Mostafa-Samy-Mohammed/MCT411-HybridControlSystems-Project/report/hybrid_report_team16.pdf

# Final Project Report

# – Team 16 –

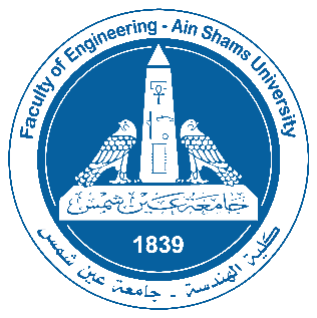
[picture p1: figure]

Name | ID
Amr Khaled Taha | 2101427
Mostafa Samy Mohammed | 2100349
Omar Mohsen Mohamed | 2100881
Youssef Ahmed Mahmoud El-Gharably | 2101548
Youssef Mostafa Kamel Mohamed | 2101019

Submitted to:
Dr. Mohamed Ibrahim Awad
Dr. Mohamed Hamdy
Eng. Hesham Salah
Eng. Mohab Ahmed

AIN SHAMS UNIVERSITY
FACULTY OF ENGINEERING

Hybrid Control Systems MCT411s Fall 2025 / Mechatronics Senior-2

2 | P a g e

## Table of Contents

3 | P a g e

## List of figures

Figure 1. Parameter estimation experiment [1] plot | 5
Figure 2. Parameter estimation experiment [2] plot | 6
Figure 3. Parameter estimation validation plot | 6
Figure 4. Simscape multibody block diagram of the system | 7
Figure 5. DC motor model | 8
Figure 6. The system model in mechanics explorer | 8
Figure 7. Linearization result state space model | 9
Figure 8. SIL [Software in the loop] | 11
Figure 9. Motor's angular velocity graph | 12
Figure 10. Motor's torque graph | 12
Figure 11. Manufactured rotary inverted pendulum | 13
Figure 12. Rotary inverted pendulum [Furuta pendulum] | 14
Figure 13. HIL block diagram | 15
Figure 14. Encoder's feedback | 16
Figure 15. Angle wrapping function block | 16
Figure 16. Linearity condition block diagram | 17
Figure 17. Linearity condition block | 17
Figure 18. Hardware interface and PWM generation | 18

## List of tables

Table 1. DC Motor parameters | 7
Table 2. Bill of materials [Electrical components] | 14

4 | P a g e

## Executive Summary

This report documents the design, modeling, and implementation of a Furuta Pendulum (Rotary Pendulum) control system. The primary objective is to stabilize the pendulum in the upright position (θ1 = 0) and reject external disturbances using a Linear Quadratic Regulator (LQR) combined with an energy-based Swing-Up controller.

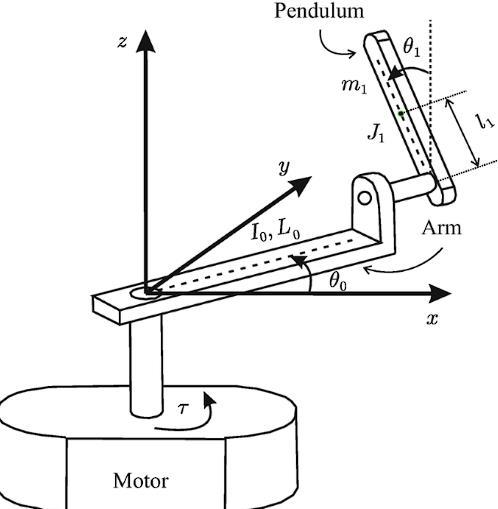
[picture p2: figure]

- Project Pipeline & Methodology: The project followed a structured pipeline architecture:

### 1. System Design: Selection of mechanical and electrical components including a

custom PCB shield for the ESP32 microcontroller and Cytron MDD3A driver.

### 2. Parameter Estimation: Identification of DC motor electrical and mechanical

parameters using a Transfer Function (TF) block diagram approach.

### 3. Advanced Modeling: Import of the Solidworks CAD model into MATLAB Simscape

Multibody. The plant model was linearized around the upright position (θ = 0) using the identified motor torque as the joint input.
Implementation: Hardware-in-the-Loop (HIL) deployment using the ESP32 platform.
Key Achievements:
- Successfully derived a linearized state-space model from Simscape Multibody.
- Designed and tuned an LQR controller for stabilization and an energy-pumping controller for swing-up.
- Validated performance via HIL simulation showing stable regulation within required settling times.
- Demonstrated robustness against manual disturbances as per project requirements.

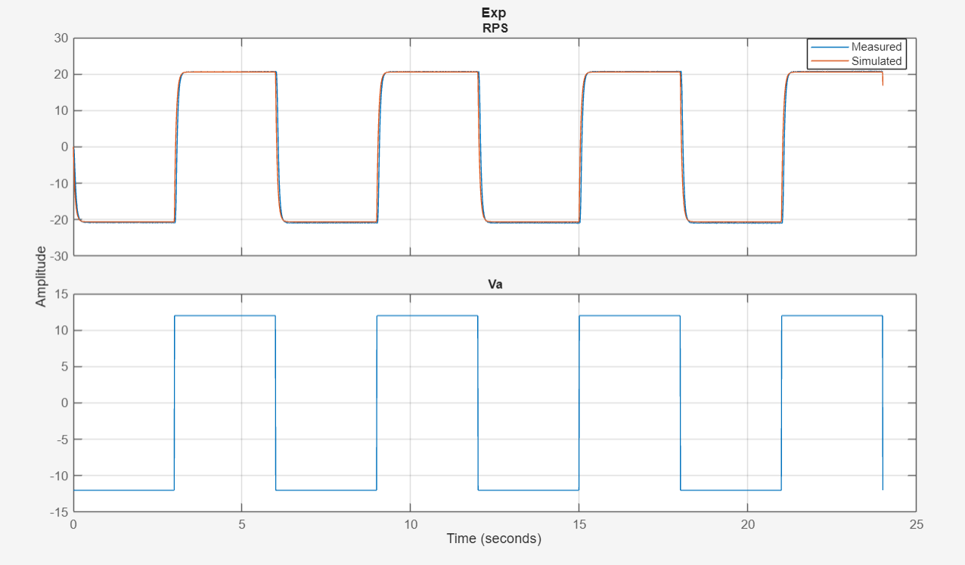
[picture p3: figure]

5 | P a g e

## Objectives

1- Use pole placement / LQR techniques to control the pendulum.
2- Control the angle θ1 to be zero. So, the pendulum stands in the upright position. 3- Overcome any disturbances that may affect the pendulum. So, the pendulum should maintain its upright position and not fall.

## System Modeling

System Description
The Furuta Pendulum consists of a horizontal rotating arm (actuated by a DC motor) and a non-actuated vertical pendulum. The system is underactuated, having two degrees of freedom but only one control input (motor torque τ).
Parameter estimation
To ensure high-fidelity simulation, the DC motor parameters were estimated rather than relying solely on datasheet values by collecting data from the motor’s encoder at different voltages with square signal generator. For validation we have also operated the motor with staircase signal voltage.

Analysis

Figure 1. Parameter estimation experiment [1] plot

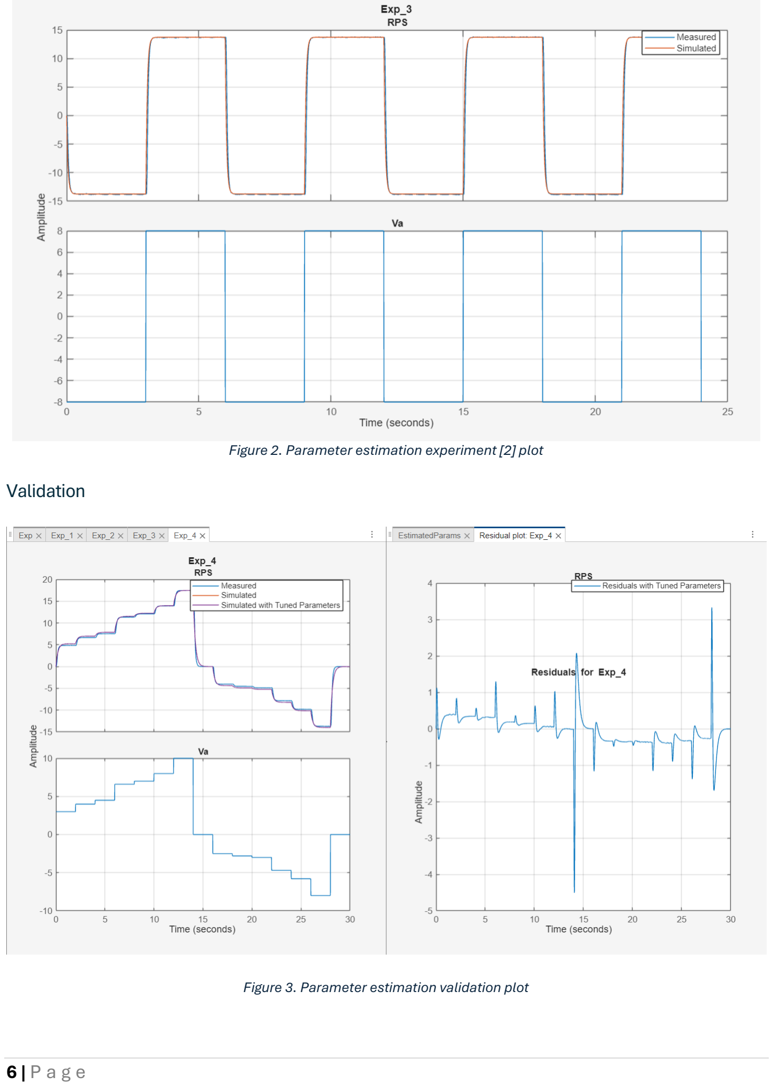
[picture p4: page 6]

6 | P a g e

Figure 2. Parameter estimation experiment [2] plot
Validation

Figure 3. Parameter estimation validation plot

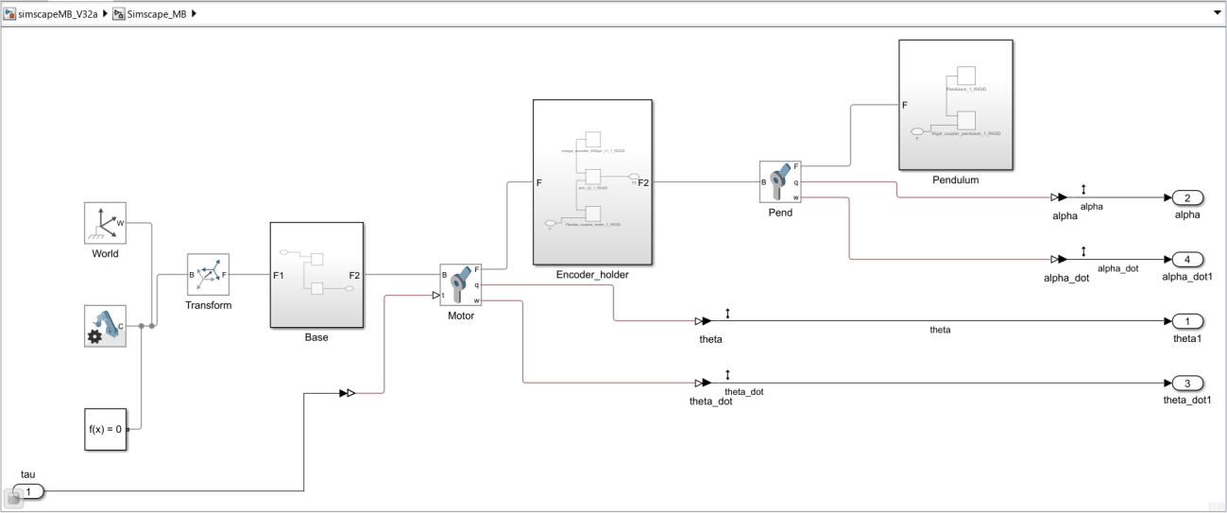
[picture p5: figure]

7 | P a g e

Results
Using a Transfer Function block diagram approach, we identified the following parameters for the motor equivalent circuit and mechanical dynamics:

Table 1. DC Motor parameters

Parameter | Symbol | Estimated Value
Armature Resistance | Ra | 9.86 Ω
Inductance | La | 0.00045 H = 0.45 mH
Back-EMF Constant | Kb | 0.5686 V/(rad/s)
Torque Constant | Kt | 1.2739 N ∙ m/A
Rotor Inertia | Jm | 0.0068 kg ∙ m²
Viscous Friction | bm | 0.0018 N ∙ m ∙ s
Simscape Multibody Model
Instead of manual Euler-Lagrange derivation alone, the system dynamics were modeled by importing the Solidworks CAD assembly into MATLAB Simscape Multibody.
1. CAD Import: The Solidworks model was exported to an XML definition and imported into Simulink.

Figure 4. Simscape multibody block diagram of the system
2. Actuation: The identified DC motor model (from Section 1.2) was coupled to the arm joint, providing torque τ based on voltage input V.

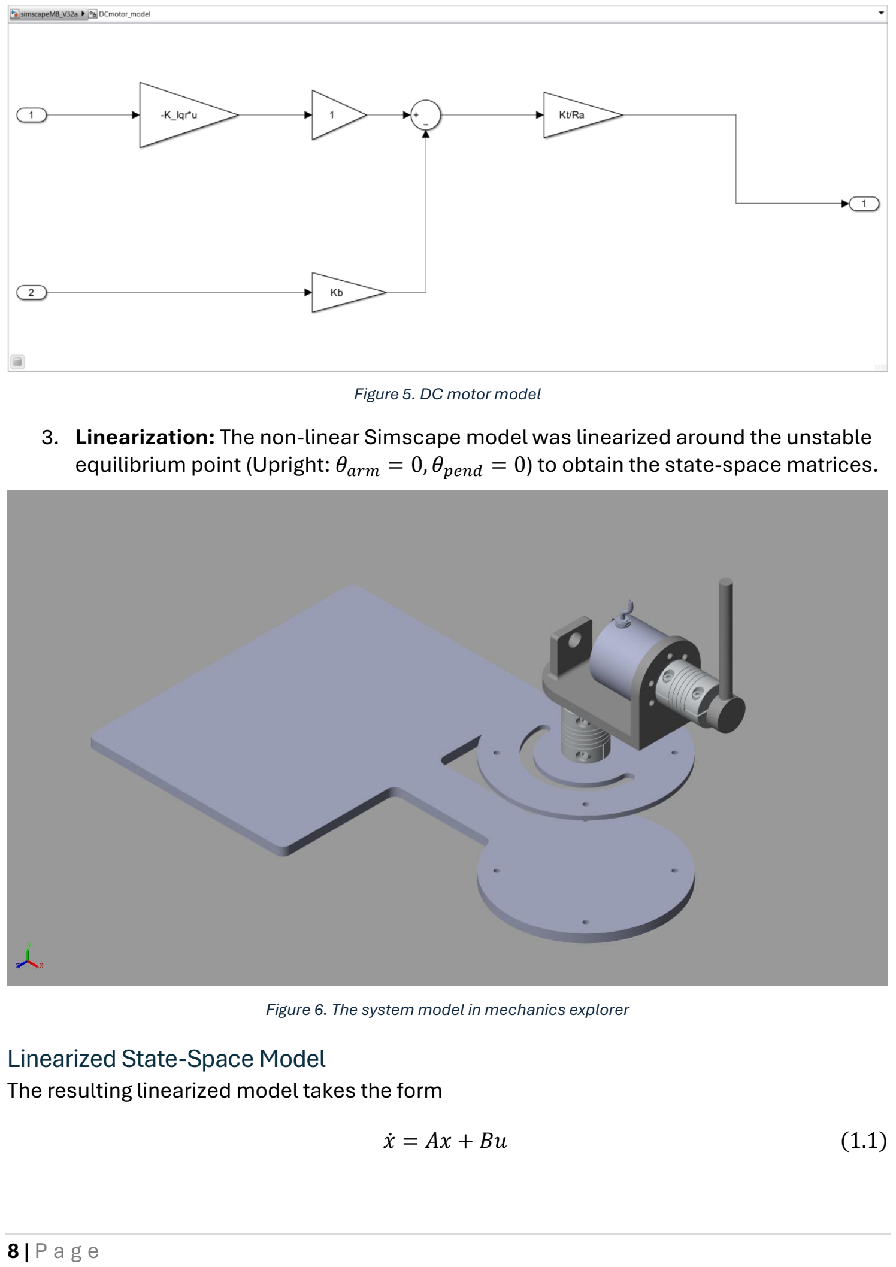
[picture p6: page 8]

8 | P a g e

Figure 5. DC motor model
3. Linearization: The non-linear Simscape model was linearized around the unstable equilibrium point (Upright: θarm = 0, θpend = 0) to obtain the state-space matrices.

Figure 6. The system model in mechanics explorer
Linearized State-Space Model
The resulting linearized model takes the form
ẋ = Ax + Bu | (1.1)

9 | P a g e
y = Cx + Du | (1.2)
, where:
- State vector
x = [θ0, α1, θ̇
0, α̇1]

T
(1.3)
- Output vector
u = [θ0, α1
] | (1.4)
- System parameters matrix
A = [
0 | 1 | 0 | 0
0 | 0 | 0 | 1
~0 a32 | a33 | ~0
~0 a42 | a43 | a44
] | (1.5)

B = [

0
b2
0
b4
] | (1.6)

C = [

1 0 0 0
0 1 0 0
] | (1.7)
D = 0 | (1.8)
Results
After linearization of the system at θ = 180∘

, the result state space model is given below:

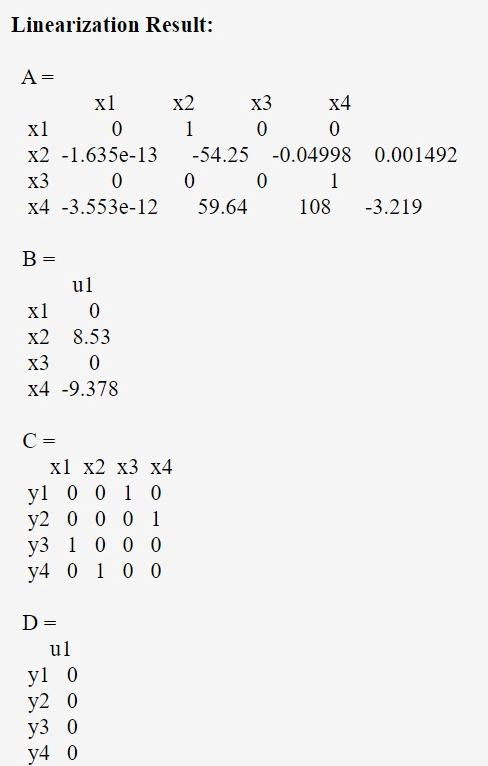
[picture p7: figure]

Figure 7. Linearization result state space model

10 | P a g e

## Controller Design

Control Strategy
The control architecture consists of two distinct controllers switched based on the pendulum’s state:
1. Swing-Up Controller: Brings the pendulum from the downward (stable) position to the upright region [−

π
8

∶

π
8

].
2. Stabilization Controller (LQR): Balances the pendulum once it is within a small angular threshold of the upright position [−

π
8

∶

π
8

].
Stabilization: LQR Design
We utilized the Linear Quadratic Regulator (LQR) method to calculate the optimal gain matrix K that minimizes the cost function:

J = ∫ (x
TQx + u

TRu)

∞

0

dt | (2)

Weight Selection
The weighting matrices were tuned to prioritize pendulum angle error (θ1) minimization while respecting motor voltage limits.

Q = [

Qθ | 0 | 0 | 0
0 | Qα | 0 | 0
0 | 0 | Qθ̇ | 0
0 | 0 | 0 | Qα̇

] = [

10 | 0 | 0 | 0
0 | 250 | 0 | 0
0 | 0 | 1.5 | 0
0 | 0 | 0 | 80] | (3)
R = Ru = 3 | (4)
Resulting Gain
The calculated state-feedback gain K:
K = [k1 k2 k3 k4
] = [ − 2.2361 219.4128 − 2.0954 14.9704] | (5)
Swing-Up Controller

The fundamental idea is based on the Total Mechanical Energy ($E$) of the system. The controller treats the pendulum as an energy management problem rather than a trajectory tracking problem.

1. Target Energy [Eref]: You calculate the potential energy the pendulum possesses when it is perfectly upright and stationary. This is your reference energy.
2. Current Energy [E]: At every time step, the system calculates the pendulum's current kinetic and potential energy.
3. Energy Error: The difference between the two (E − Eref) dictates the control action.

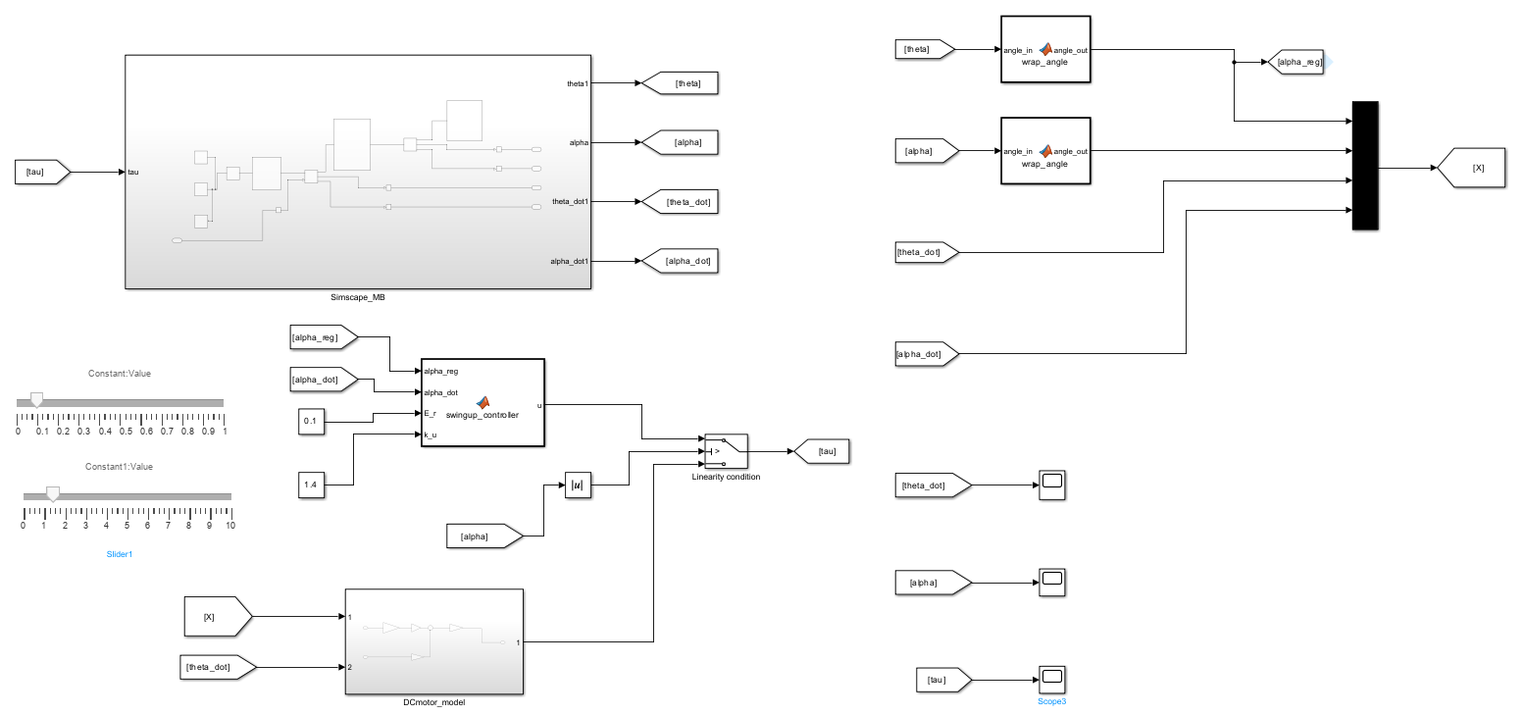
[picture p8: figure]

11 | P a g e

Mathematically, the control law u (torque applied to the rotary base) often looks like this:

u = k ⋅ (E − Eref) ⋅ α̇ ⋅ cos α | (6)
, where:
- k is a tunable gain.
- E is the current total energy.
- α̇ is the pendulum angular velocity.
- cos α ensures the force is applied effectively relative to the arm's rotation (geometric coupling).

## Software-in-the-loop (SIL)

To ensure the reliability and safety of the control algorithms prior to physical deployment, a high-fidelity Software-in-the-Loop (SIL) simulation environment was developed. This architecture decouples the control logic from the physical hardware, allowing the exact control code to be tested against a virtual "digital twin" of the rotary inverted pendulum.

Figure 8. SIL [Software in the loop]

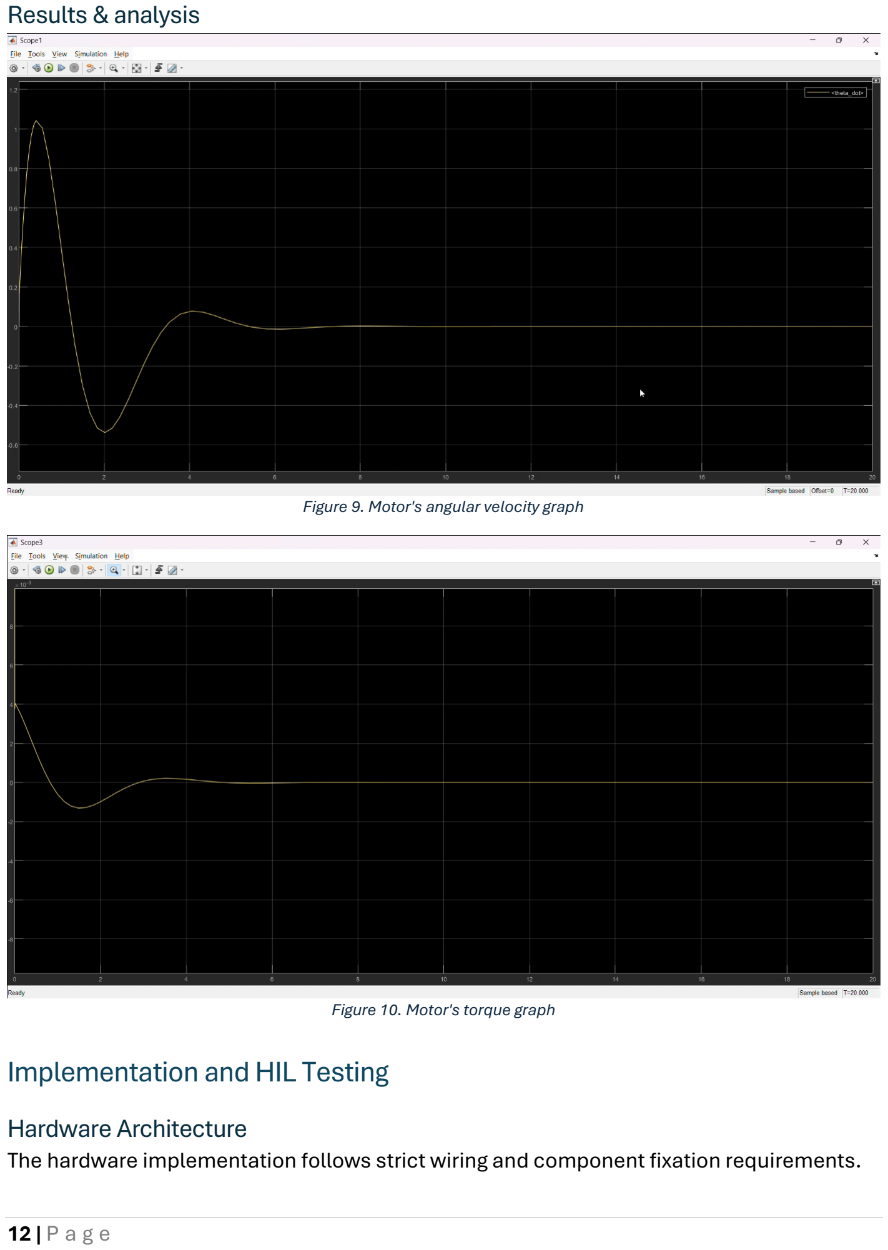
[picture p9: page 12]

12 | P a g e

Results & analysis

Figure 9. Motor's angular velocity graph

Figure 10. Motor's torque graph

## Implementation and HIL Testing

Hardware Architecture
The hardware implementation follows strict wiring and component fixation requirements.

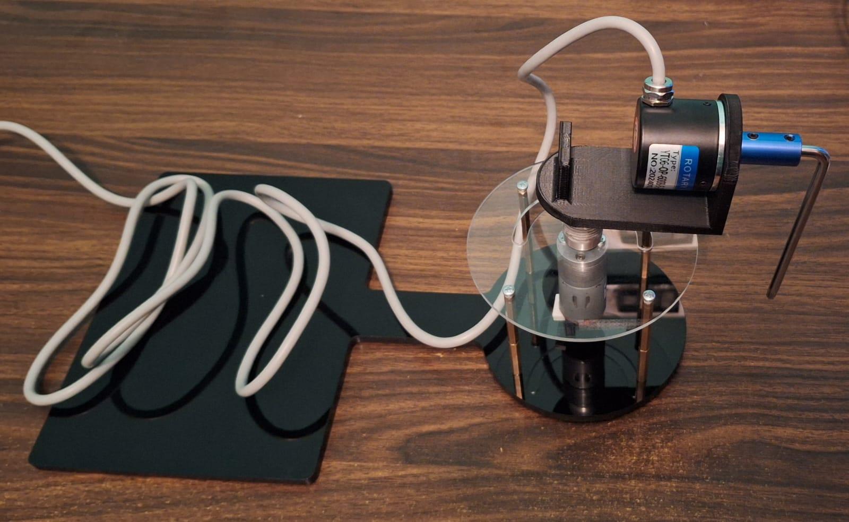
[picture p10: figure]

13 | P a g e

Figure 11. Manufactured rotary inverted pendulum

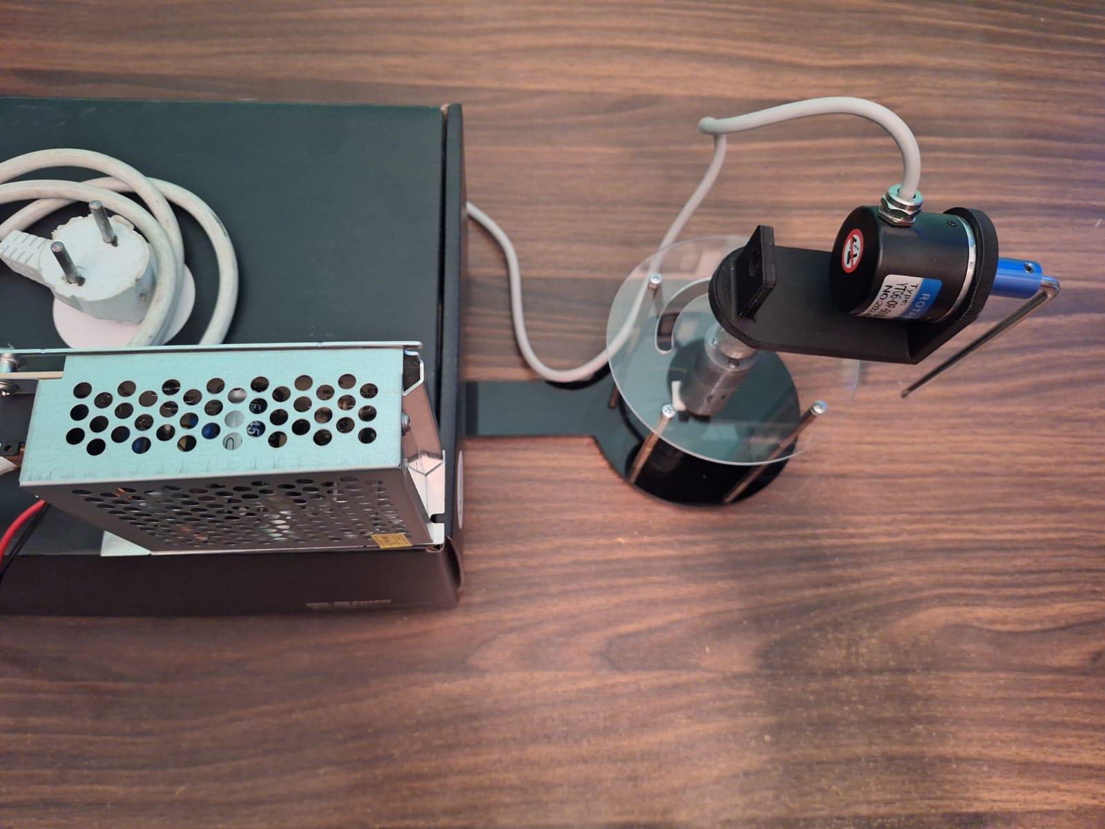
[picture p11: figure]

14 | P a g e

Figure 12. Rotary inverted pendulum [Furuta pendulum]
Electronics and PCB
To ensure reliability and reduce wiring clutter, a custom PCB shield was designed for the microcontroller.

Table 2. Bill of materials [Electrical components]
Component | Model/Specs | Role
Microcontroller | ESP32-DevkitC-38pin | Main controller (HIL Interface)
Motor driver | Cytron MDD3A | High-current DC motor drive
Power supply | 12V DC – 5A Supply | System power supply
Rotary incremental encoder | 11 PPR [2090 PPR after gearbox in MATLAB Simulink]
Optical rotary incremental encoder | 600 PPR [2400 PPR in MATLAB Simulink] | State feedback (θ0, θ1)
Shield | Custom PCB | Interconnects ESP32, Driver, and Encoders

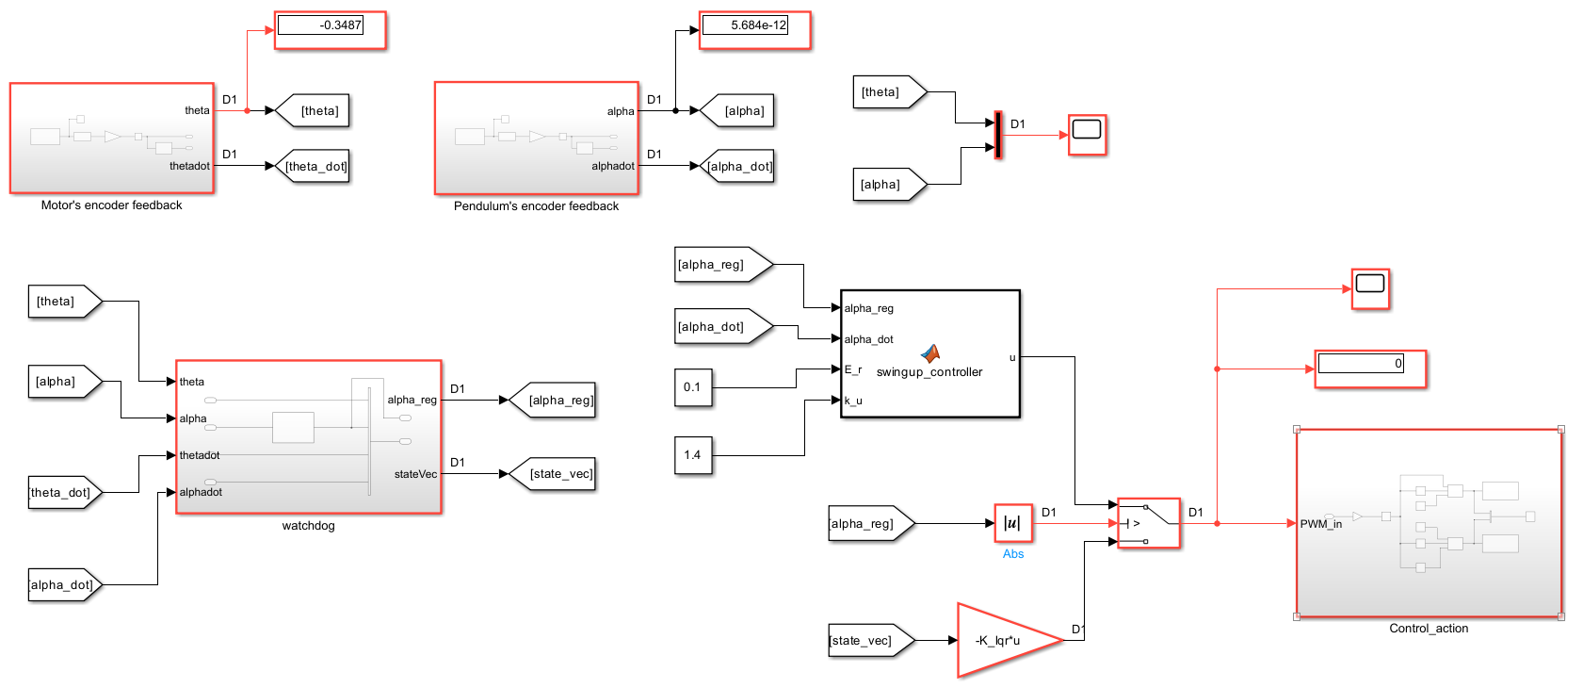
[picture p12: figure]

15 | P a g e

Hardware-in-the-Loop (HIL)
Hardware-in-the-Loop (HIL) implementation for the autonomous Furuta inverted pendulum project. The system is designed to interface an ESP32 microcontroller with MATLAB/Simulink to achieve real-time balancing control using an LQR (Linear Quadratic Regulator) strategy.

Figure 13. HIL block diagram

### 1. Encoder Feedback and State Estimation

The first stage of the HIL system focuses on acquiring the physical states of the pendulum. The system utilizes two distinct encoder inputs: one for the DC motor (arm position) and one for the rotary encoder (pendulum angle). Within the Simulink environment, raw encoder counts are received via hardware interruptions and converted into a double precision format. These counts are then scaled by a gain block (deg) and converted to radians (D2R) to represent the angular position, theta.
To derive the angular velocity, theta_dot, the signal is passed through a Filtered Derivative block. This block implements a first-order lead-lag transfer function, s/(0.03s+1), which calculates the derivative while simultaneously applying a low-pass filter with a 0.03s time constant. This filtering is critical to mitigate the high-frequency quantization noise inherent in digital encoder signals, ensuring a smooth velocity estimate for the LQR controller.

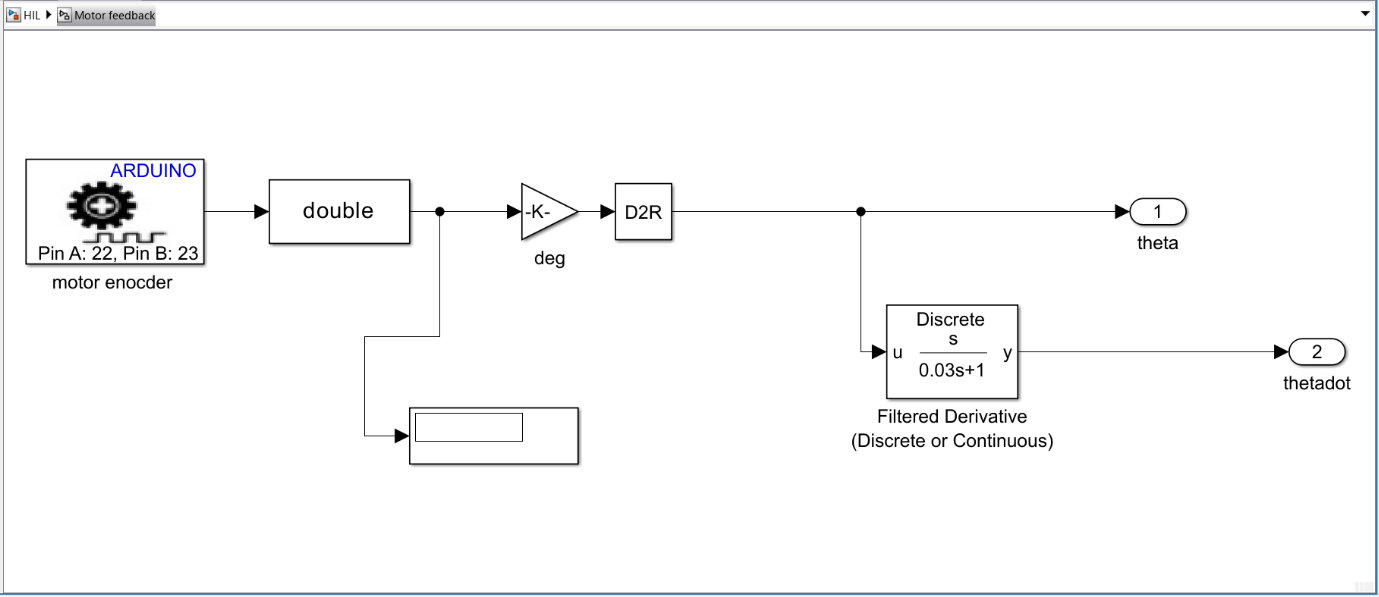
[picture p13: figure]

16 | P a g e

Figure 14. Encoder's feedback

### 2. Angle Wrapping Logic

To ensure the controller operates within a consistent coordinate system, the angular data is processed through an Angle Wrapper section. This is implemented via a MATLAB Function block that constrains the input angle (in radians) to the range [-pi, pi]. The wrapping is achieved using the trigonometric identity atan2(sin(angle_in), cos(angle_in)). This operation prevents the controller from attempting to "unwind" the pendulum if it completes multiple full rotations, maintaining a continuous and bounded state representation for both the arm and the pendulum angles.

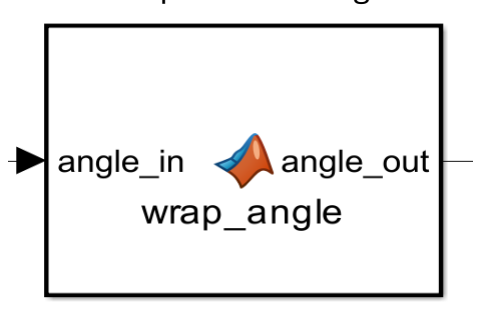
[picture p14: figure]

Figure 15. Angle wrapping function block

### 3. Linearity Condition and LQR Control Switching

The control logic employs a Linearity Condition to manage the transition between the inactive state and active balancing. The system monitors the absolute value of the wrapped pendulum angle (|u|). A switch block, labeled "linearity condition," remains at a default output of 0 until the pendulum is manually swung into the upright vertical position.

17 | P a g e

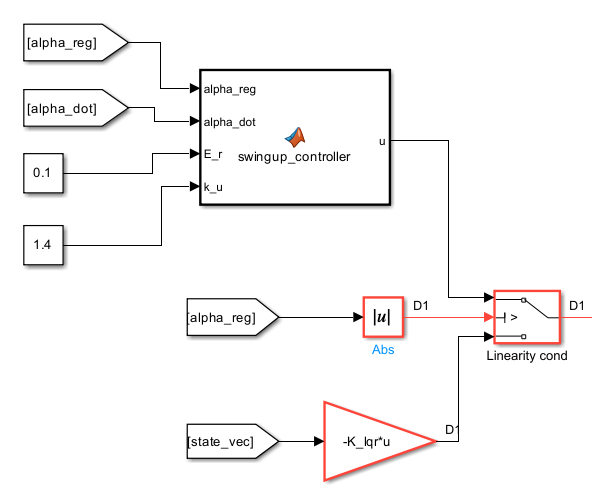
[picture p15: figure]

Figure 16. Linearity condition block diagram
When the pendulum angle (alpha) falls within the linear region—defined as being less than pi/8 radians from the vertical—the system switches to the active control state. In this mode, the full state vector of the inverted pendulum is multiplied by the pre-calculated LQR Gains (K). This LQR strategy minimizes a cost function to provide the optimal torque required to stabilize the pendulum in the upright position.

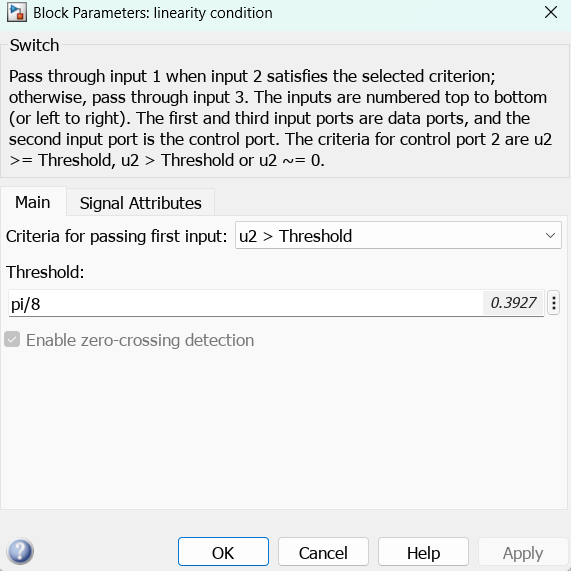
[picture p16: figure]

Figure 17. Linearity condition block

### 4. Motor Hardware Interface and PWM Generation

The final section translates the calculated control action into physical movement via the motor driver. The control signal is first processed through a gain and a saturation block to

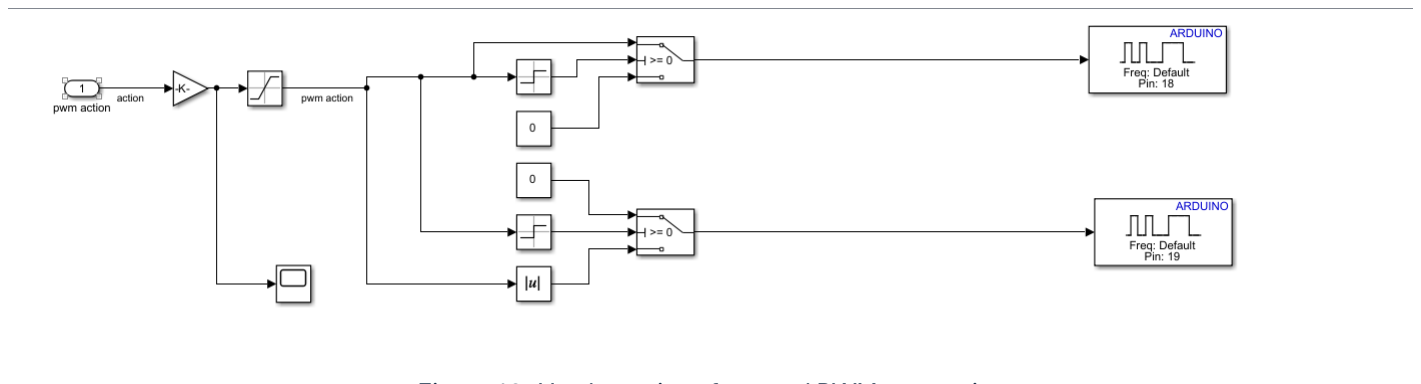
[picture p17: figure]
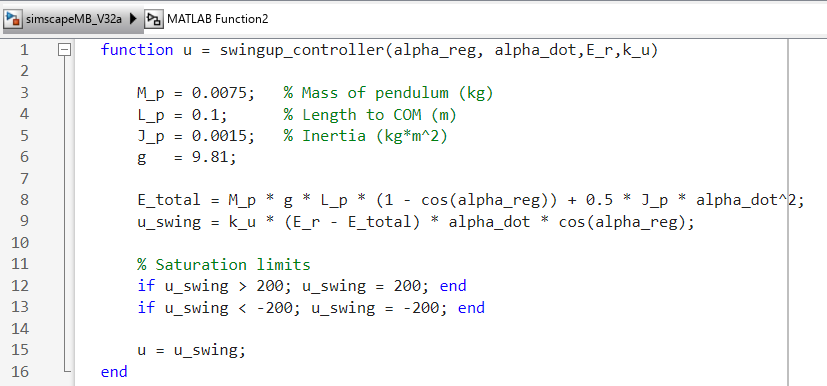
[picture p18: figure]

18 | P a g e

ensure the PWM action remains within the hardware limits of the Cytron motor driver. This saturated signal is then split into two paths to control the motor direction and speed.

Using logic gates and switch blocks, the system determines the sign of the control action. If the action is positive, a PWM signal proportional to the absolute value (|u|) is sent to Pin 18, while Pin 19 is held at 0. Conversely, if the action is negative, the PWM signal is routed to Pin 19 while Pin 18 is grounded. These digital outputs are sent directly to the ESP32 pins to drive the motor, completing the real-time HIL control loop.

Figure 18. Hardware interface and PWM generation

## Appendix

Swing-up controller function

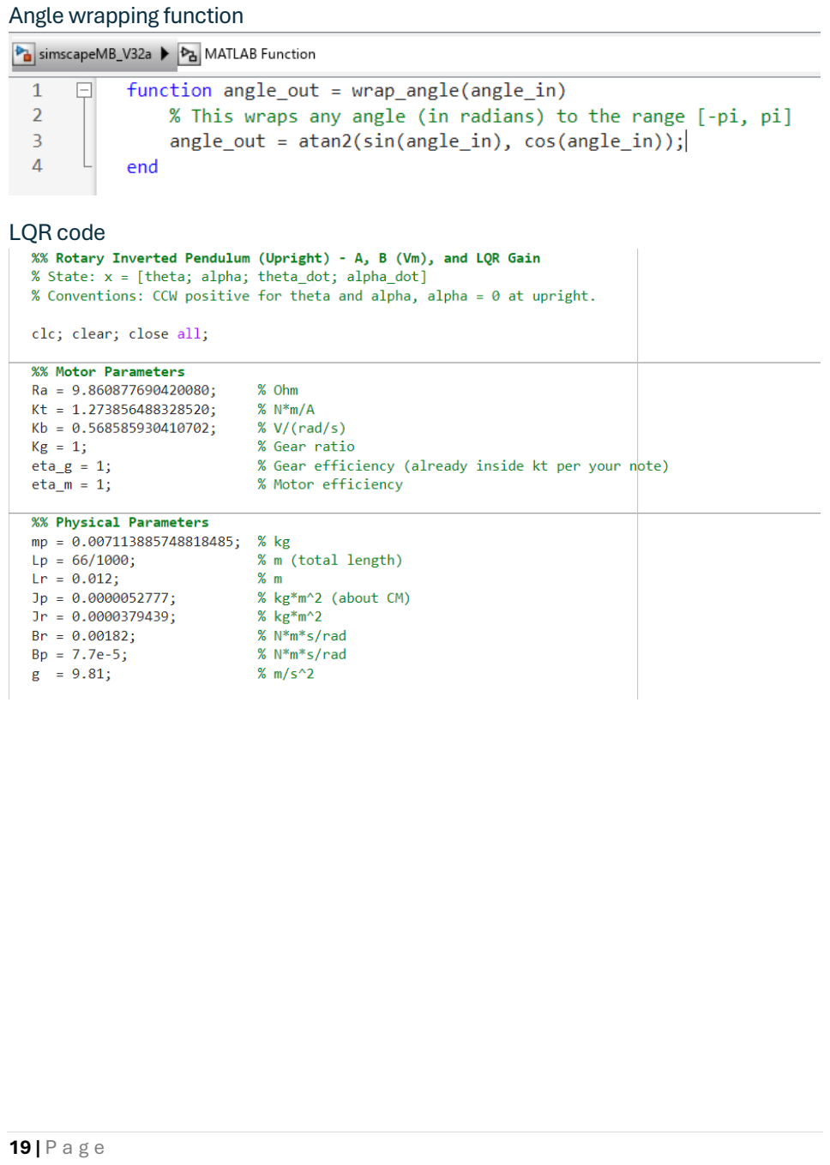
[picture p19: page 19]

19 | P a g e

Angle wrapping function

LQR code

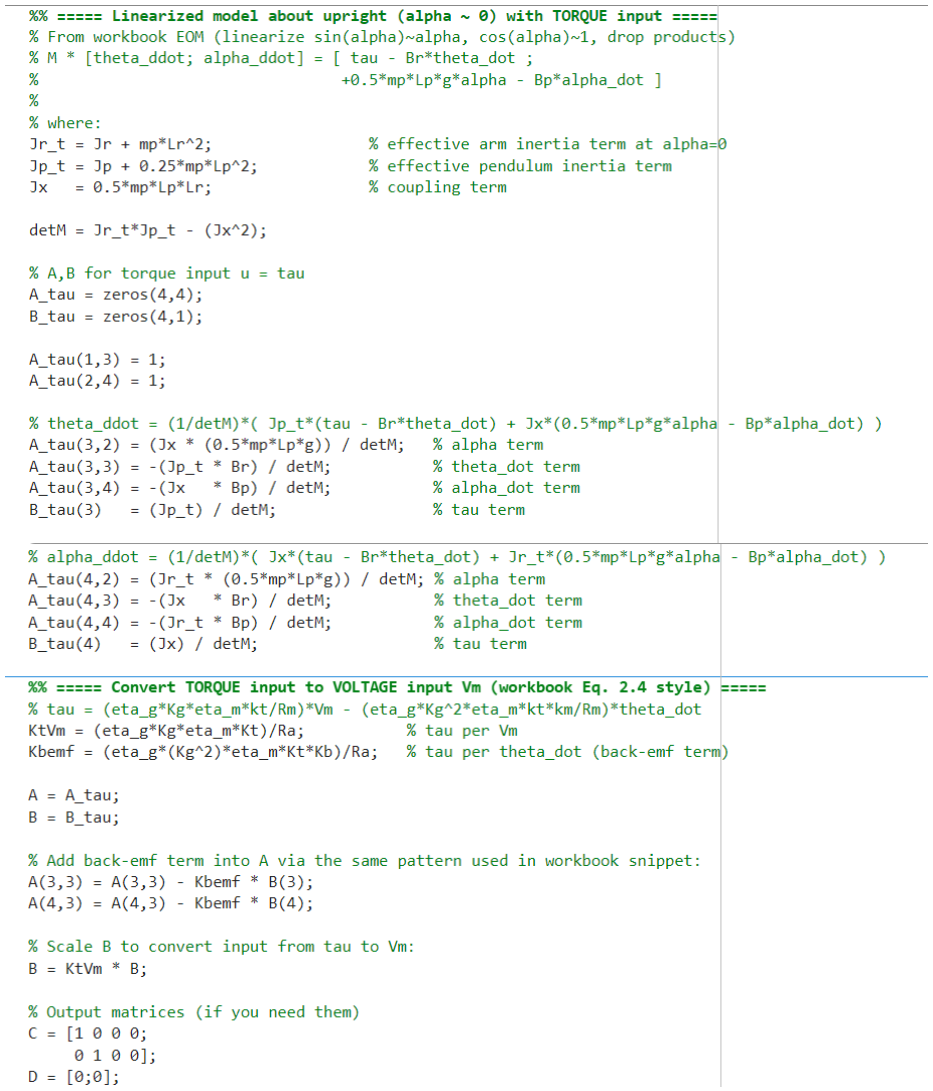
[picture p20: figure]

20 | P a g e

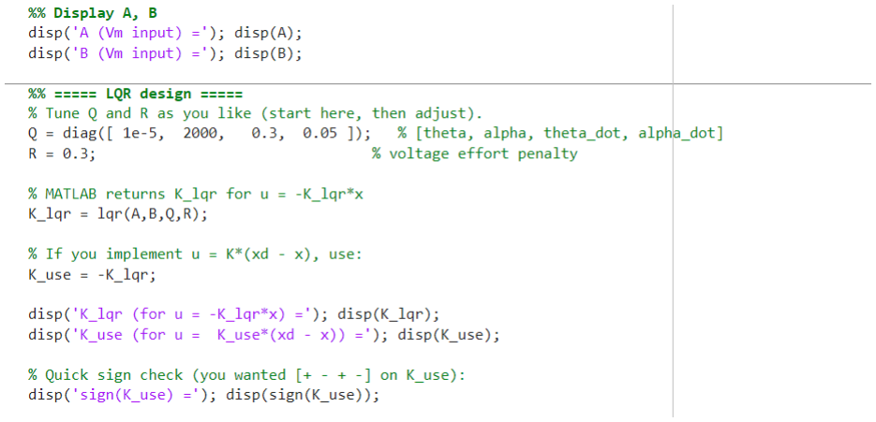
[picture p21: figure]

21 | P a g e
