Mostafa-Samy-Mohammed/MCT411-HybridControlSystems-Project/CAD/Assem1.SLDASM

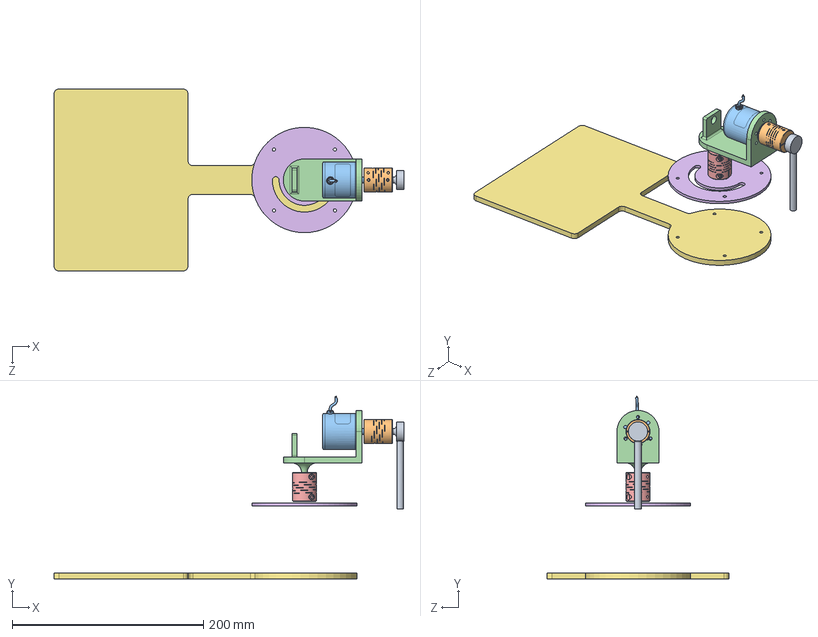
[picture p22: CAD file, 2025-12-24]
CAD/Assem1.SLDASM
365.6 x 190.7 x 190.0 mm
base_plate
dcMotor_plate
Flexible_coupler_motor
arm_v2
orange_encoder_600ppr v1
Rigid_coupler_pendulum
Pendulum
