Mostafa-Samy-Mohammed/MCT411-HybridControlSystems-Project/CAD/Flexi_spojka_D25 L30.SLDPRT

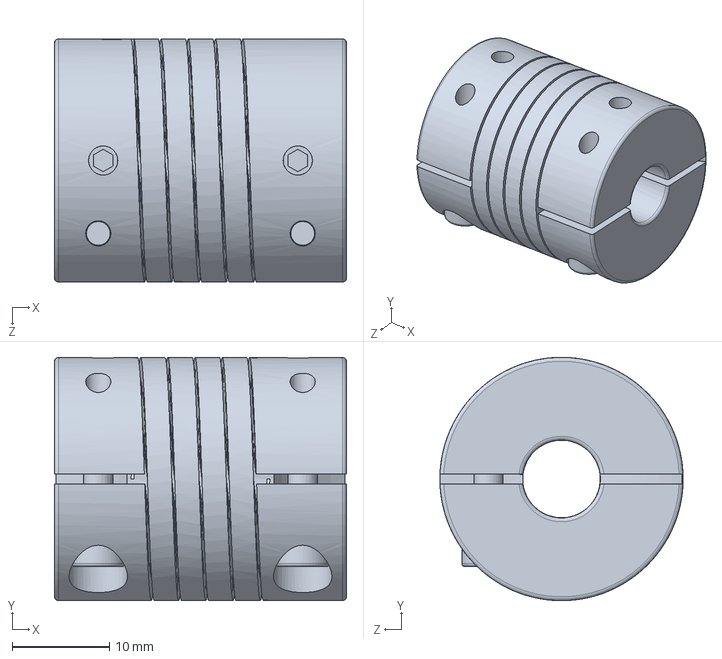
[picture p23: CAD file, 2025-12-24]
CAD/Flexi_spojka_D25 L30.SLDPRT
30.0 x 25.0 x 25.0 mm
