Mostafa-Samy-Mohammed/MCT411-HybridControlSystems-Project/CAD/Simscape-Multibody/dcMotor_plate_Default_sldprt.STEP

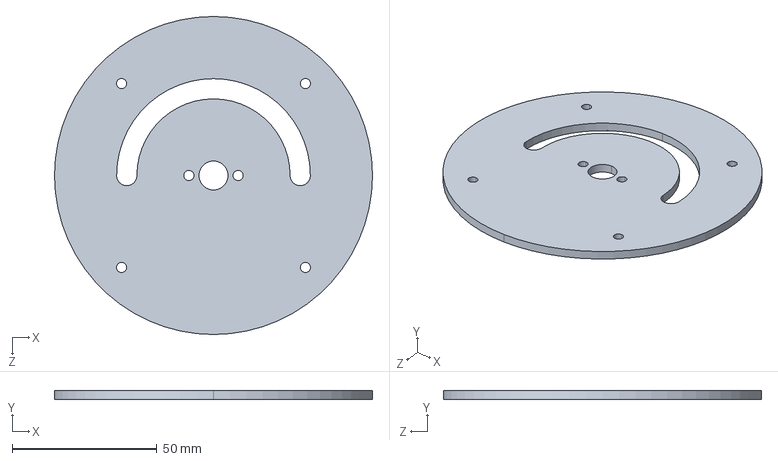
[picture p24: CAD file, 2025-12-24]
CAD/Simscape-Multibody/dcMotor_plate_Default_sldprt.STEP
110.0 x 3.00 x 110.0 mm
