Mostafa-Samy-Mohammed/MCT411-HybridControlSystems-Project/CAD/Simscape-Multibody/arm_v2_Default_sldprt.STEP

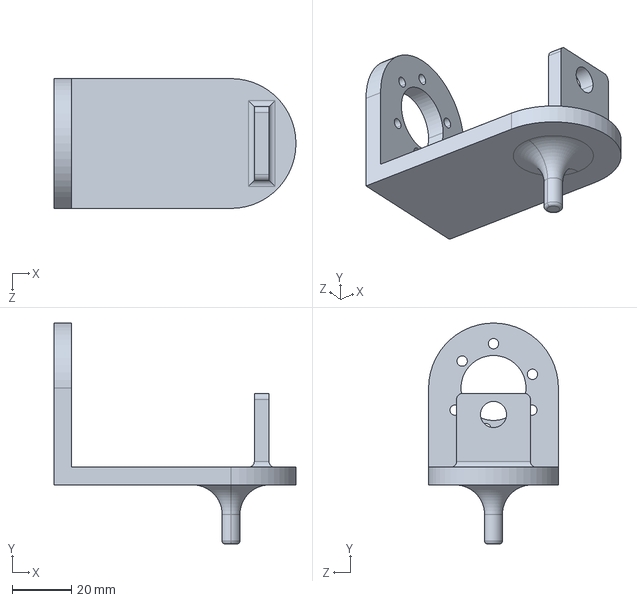
[picture p25: CAD file, 2025-12-24]
CAD/Simscape-Multibody/arm_v2_Default_sldprt.STEP
82.0 x 74.8 x 44.0 mm
