Mostafa-Samy-Mohammed/MCT411-HybridControlSystems-Project/CAD/orange_encoder_600ppr v1.SLDPRT

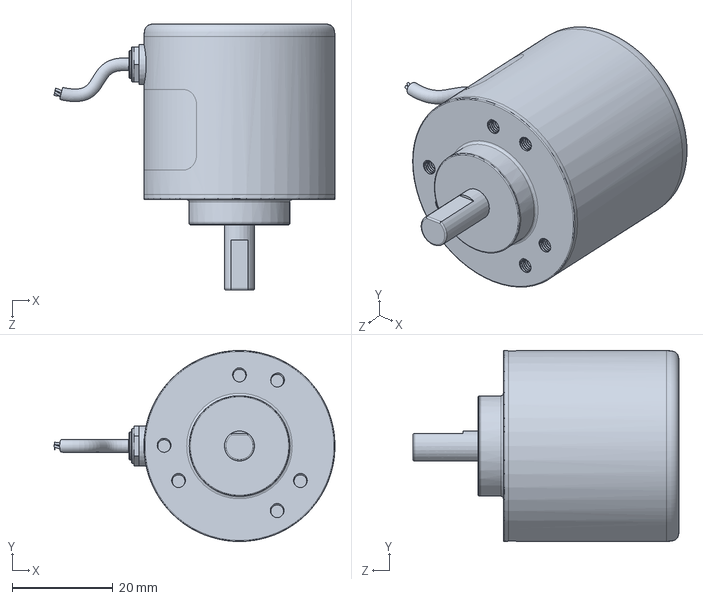
[picture p26: CAD file, 2025-12-24]
CAD/orange_encoder_600ppr v1.SLDPRT
55.9 x 38.0 x 53.0 mm
