Mostafa-Samy-Mohammed/MCT411-HybridControlSystems-Project/CAD/Simscape-Multibody/base_plate_Default_sldprt.STEP

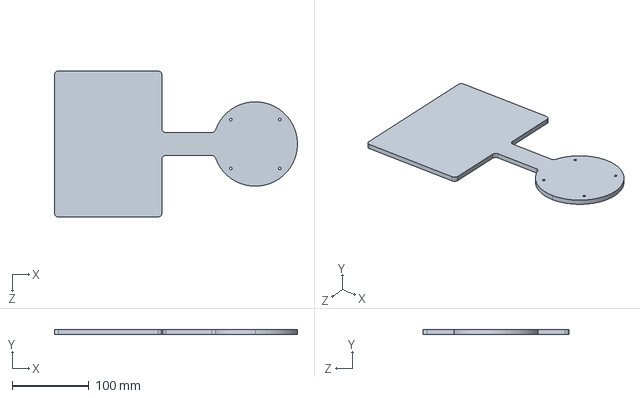
[picture p27: CAD file, 2025-12-24]
CAD/Simscape-Multibody/base_plate_Default_sldprt.STEP
316.6 x 6.00 x 190.0 mm
