Mostafa-Samy-Mohammed/MCT411-HybridControlSystems-Project/CAD/Simscape-Multibody/Rigid_coupler_pendulum_Default_sldprt.STEP

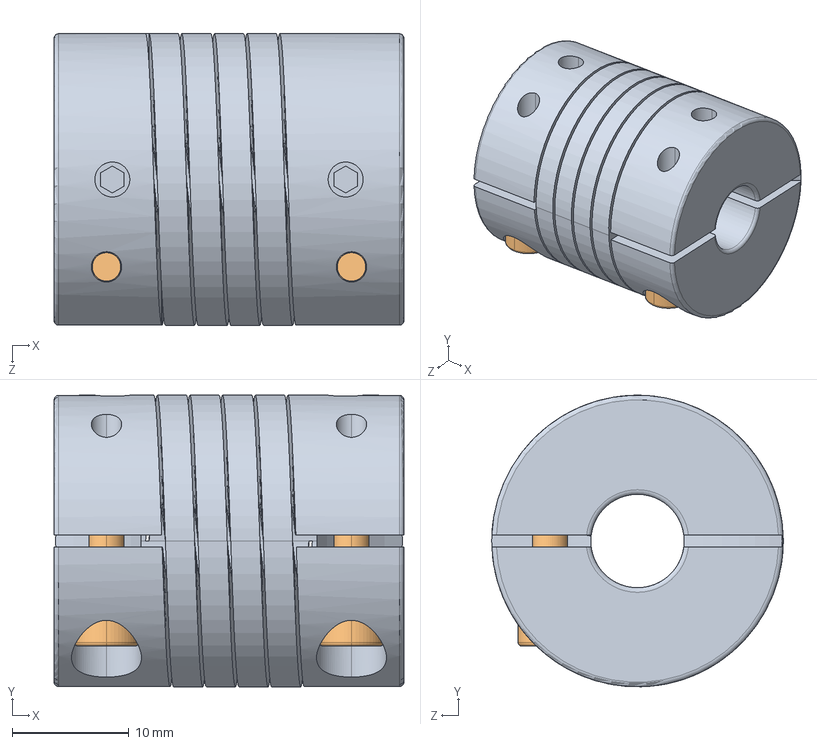
[picture p28: CAD file, 2025-12-24]
CAD/Simscape-Multibody/Rigid_coupler_pendulum_Default_sldprt.STEP
30.0 x 25.0 x 25.0 mm
