Mostafa-Samy-Mohammed/MCT411-HybridControlSystems-Project/CAD/Simscape-Multibody/Pendulum_Default_sldprt.STEP

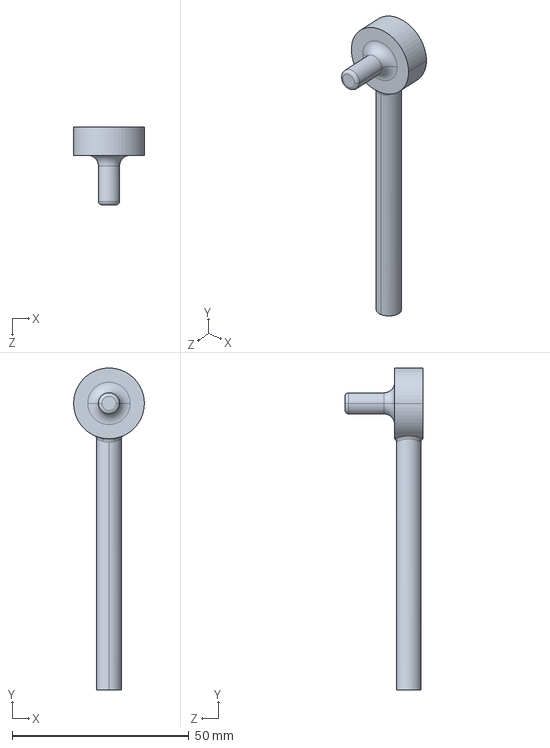
[picture p29: CAD file, 2025-12-24]
CAD/Simscape-Multibody/Pendulum_Default_sldprt.STEP
20.0 x 91.0 x 22.0 mm
