Mostafa-Samy-Mohammed/MCT411-HybridControlSystems-Project/(list of files, cad)

Other CAD files:
CAD/Rigid_coupler_pendulum.SLDPRT
CAD/arm_v2.SLDPRT
CAD/dcMotor_plate.SLDPRT
CAD/Simscape-Multibody/Flexible_coupler_motor_Default_sldprt.STEP
CAD/Flexible_coupler_motor.SLDPRT
CAD/Pendulum.SLDPRT
CAD/base_plate.SLDPRT
CAD/DWG/DCmotor_plate.DWG
CAD/DWG/base_plate.DWG
CAD/DXF/DCmotor_plate.DXF
CAD/DXF/base_plate.DXF
